Arcturus314/voltage_preamp/kicad/voltage_preamp.kicad_pcb

## KiCad design kicad/voltage_preamp.kicad_pcb (2021-05-09)

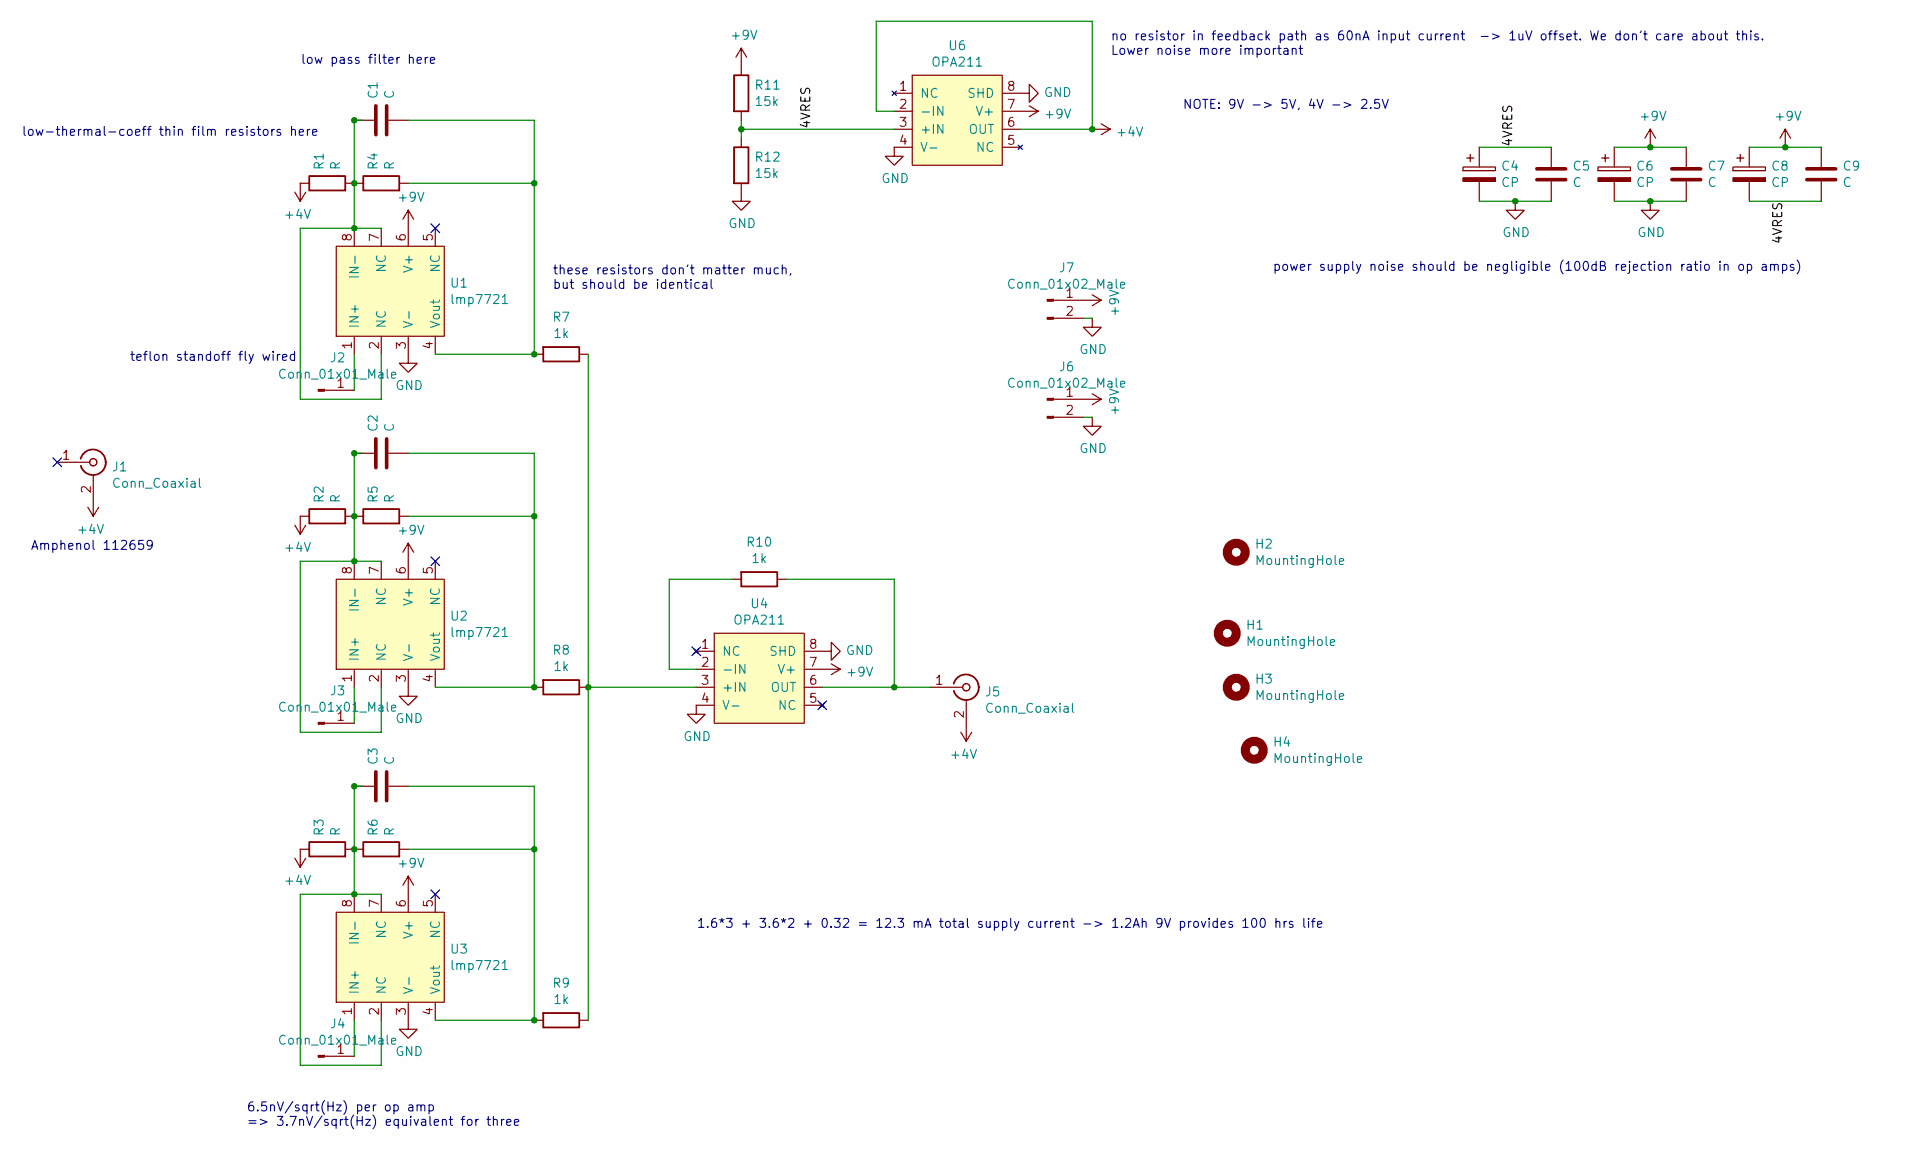
[picture p1: schematic voltage_preamp.sch]

Parts:
C1, C2, C3, C5, C7, C9: C; C_0805_2012Metric_Pad1.15x1.40mm_HandSolder
C4, C6, C8: CP; PinHeader_1x02_P2.54mm_Vertical
H1, H3, H4: MountingHole; MountingHole_3.2mm_M3
H2: MountingHole; MountingHole_3.2mm_M3_DIN965
J1, J5: Conn_Coaxial; BNC_Amphenol_B6252HB-NPP3G-50_Horizontal
J2, J3, J4: Conn_01x01_Male; PinHeader_1x01_P2.54mm_Vertical
J6: Conn_01x02_Male; BatteryHolder_Keystone_2479_3xAAA
J7: Conn_01x02_Male; BNC_Amphenol_B6252HB-NPP3G-50_Horizontal
R1, R2, R3, R4, R5, R6: R; R_0805_2012Metric_Pad1.15x1.40mm_HandSolder
R7, R8, R9, R10: 1k; R_0805_2012Metric_Pad1.15x1.40mm_HandSolder
R11, R12: 15k; R_0805_2012Metric_Pad1.15x1.40mm_HandSolder
U1, U2, U3: lmp7721
U4, U6: OPA211; VSSOP-8_3.0x3.0mm_P0.65mm

Connections:
+4V: J1.2 (Ext), J5.2 (Ext), R1.1, R2.1, R3.1, U6.2 (-IN), U6.6 (OUT)
+9V: C6.1, C7.1, C8.1, C9.1, J6.1, J7.1, R11.1, U1.6 (V+), U2.6 (V+), U3.6 (V+), U4.7 (V+), U6.7 (V+)
/4VRES: C4.1, C5.1, C8.2, C9.2, R11.2, R12.1, U6.3 (+IN)
GND: C4.2, C5.2, C6.2, C7.2, J6.2, J7.2, R12.2, U1.3 (V-), U2.3 (V-), U3.3 (V-), U4.4 (V-), U4.8 (SHD), U6.4 (V-), U6.8 (SHD)
unnamed: C1.1, R1.2, R4.1, U1.2 (NC), U1.7 (NC), U1.8 (IN-)
unnamed: C1.2, R4.2, R7.2, U1.4 (Vout)
unnamed: C2.1, R2.2, R5.1, U2.2 (NC), U2.7 (NC), U2.8 (IN-)
unnamed: C2.2, R5.2, R8.2, U2.4 (Vout)
unnamed: C3.1, R3.2, R6.1, U3.2 (NC), U3.7 (NC), U3.8 (IN-)
unnamed: C3.2, R6.2, R9.2, U3.4 (Vout)
unnamed: J2.1, U1.1 (IN+)
unnamed: J3.1, U2.1 (IN+)
unnamed: J4.1, U3.1 (IN+)
unnamed: J5.1 (In), R10.1, U4.6 (OUT)
unnamed: R7.1, R8.1, R9.1, U4.3 (+IN)
unnamed: R10.2, U4.2 (-IN)

Notes on the sheet:
teflon standoff fly wired
low-thermal-coeff thin film resistors here
these resistors don't matter much, but should be identical
low pass filter here
power supply noise should be negligible (100dB rejection ratio in op amps)
6.5nV/sqrt(Hz) per op amp => 3.7nV/sqrt(Hz) equivalent for three
1.6*3 + 3.6*2 + 0.32 = 12.3 mA total supply current -> 1.2Ah 9V provides 100 hrs life
no resistor in feedback path as 60nA input current -> 1uV offset. We don’t care about this. Lower noise more important
NOTE: 9V -> 5V, 4V -> 2.5V
Amphenol 112659

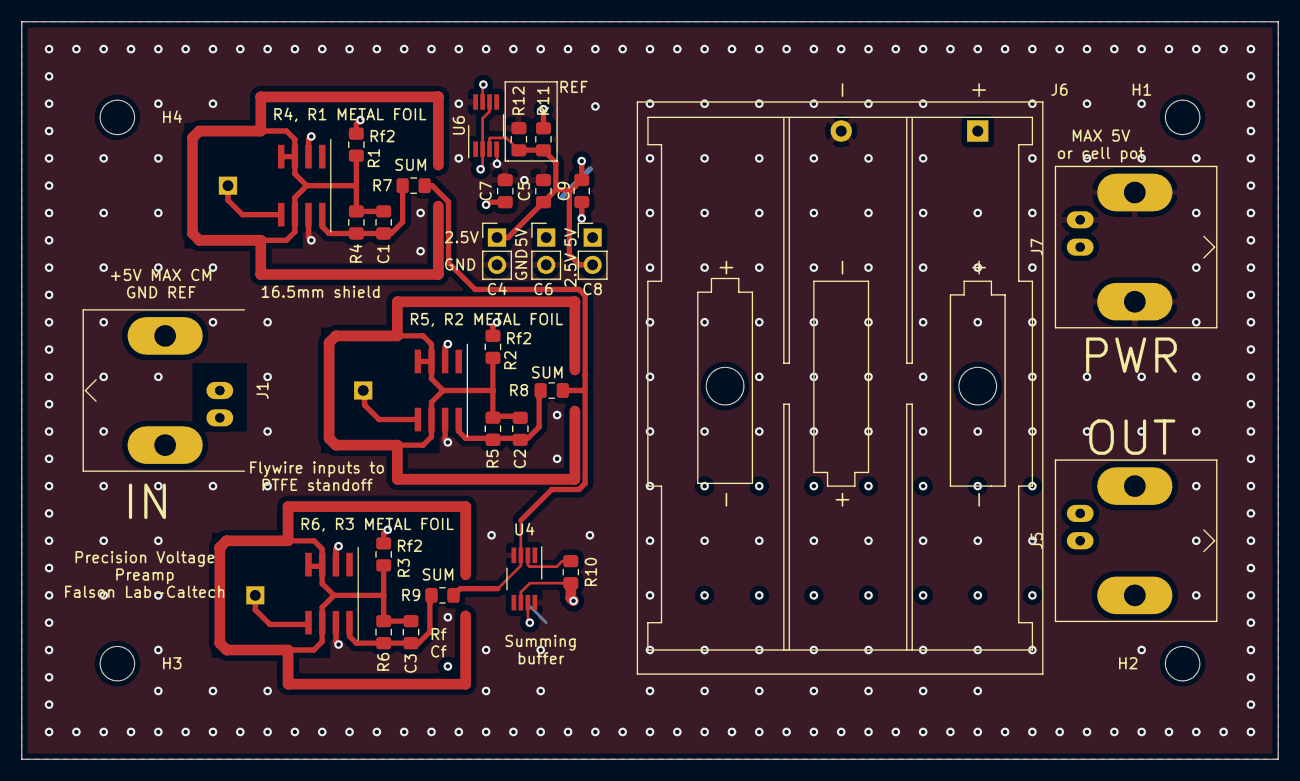
[picture p2: board voltage_preamp.kicad_pcb from above]

Board: 4 copper layers, 116.8 x 68.6 mm, 37 parts (0 on the bottom side), 16 nets.
