Arcturus314/voltage_preamp/(commit log)

2021-05-04 wip design
    [voltage_preamp.kicad_pcb, voltage_preamp.sch]
2021-05-06 v1 schematic and layout complete, simulated
    [voltage_preamp-B_Cu.gbr, voltage_preamp-B_Mask.gbr, voltage_preamp-B_Paste.gbr, voltage_preamp-B_SilkS.gbr, voltage_preamp-Edge_Cuts.gbr, voltage_preamp-F_Cu.gbr, voltage_preamp-F_Mask.gbr, voltage_preamp-F_Paste.gbr]
2021-05-06 fixed bypass cap network
    [voltage_preamp.kicad_pcb, voltage_preamp.sch]
2021-05-06 added comments
    [voltage_preamp.kicad_pcb]
2021-05-08 now using 4.5V of AAA cells for power, power input available, SMAs for power input and output
    [voltage_preamp.kicad_pcb, voltage_preamp.sch]
2021-05-09 fixed via shielding, now using bnc as output and power connectors
    [voltage_preamp.kicad_pcb, voltage_preamp.sch]
